mrshlaf/smart-plant-system/presentation/SmartPlantSystem_Presentation.pptx

GROUP 21

SMART PLANT
SYSTEM

Sistem Penyiram Tanaman Otomatis Berbasis Arduino

1. Marshal Aufa Diliyana(2406346913)

2. Syifa Naila Maulidya(2406436940)

3. Zahir(2406487084)

4. Muhamad Rifqi Fadil Itsnain (2406355306)

5. Arya Wibawa Atmanegara (2406420431)

## Slide 2

PENDAHULUAN

Merawat tanaman bukan hal yang mudah, terutama bagi kamu yang sibuk atau sering lupa menyiram. Terlalu sedikit air membuat tanaman layu, tapi terlalu banyak justru merusaknya.
Smart Plant Guardian hadir sebagai Solusi, sistem pintar yang secara otomatis memantau kelembapan tanah dan menyiram tanaman tepat saat dibutuhkan. Dilengkapi sensor suhu dan kelembapan udara, sistem ini menyesuaikan jumlah air dengan kondisi lingkungan secara real-time.

Masalah Utama

• Lupa menyiram tanaman

• Takaran air tidak tepat

• Tidak tahu kondisi tanah

• Tidak ada sistem otomatis

Dengan Smart Plant Guardian, tanaman akan selalu terhidrasi dengan takaran yang tepat dan otomatis tanpa perlu diingat.

## Slide 3

PROJECT DESCRIPTION

Apa yang dilakukan sistem ini?

Siram Otomatis

Sensor tanah mendeteksi apakah tanah kering. Kalau kering, pompa langsung nyala secara otomatis.

Pantau Lingkungan

Sensor suhu dan kelembapan udara memastikan jumlah air yang diberikan sesuai cuaca hari itu.

Tampil di Layar

LCD menampilkan status kelembapan tanah, suhu, dan kondisi pompa secara real-time.

Fitur Utama:

Deteksi Kelembapan

Mode Manual

Alert Bunyi

Deteksi Suhu

Pantau Suhu

Siram Otomatis

## Slide 4

OBJECTIVES

Tujuan dari proyek ini adalah sebagai berikut:

Menyiram tanaman secara otomatis saat tanah mulai kering, tanpa perlu campur tangan manusia.

01

Menyesuaikan jumlah air yang diberikan berdasarkan suhu udara dan kelembapan sekitar.

02

Memberikan peringatan berupa bunyi (buzzer) ketika kelembapan tanah sangat rendah / kritis.

Menampilkan informasi kondisi tanaman secara langsung di layar LCD.

03

04

Memungkinkan pemilik menyiram secara manual kapan saja dengan menekan tombol.

05

Menyimpan pengaturan batas kelembapan agar tidak hilang saat alat dimatikan.

06

## Slide 5

EQUIPMENT

Tools & komponen yang digunakan:

1. Arduino Uno

Otak utama sistem

2. Sensor Tanah

Cek basah/kering tanah

3. Sensor BME280

Ukur suhu & kelembapan udara

4. Pompa Air Mini

Menyiram secara otomatis

5. LCD 16x2

Tampilkan status sistem

6. Buzzer

Bunyi saat kondisi kritis

7. 2x Tombol

Kontrol manual & atur batas

8. MOSFET + Dioda

Pengaman & kontrol pompa

9. Proteus / Arduino IDE

Simulasi & upload program

## Slide 6

IMPLEMENTATION

Cara kerja sistem secara sederhana:

Baca Sensor

Setiap 1 detik, Arduino membaca kadar air di tanah dan suhu udara sekitar.

Tampilkan Info

LCD langsung menampilkan kelembapan, suhu, dan status pompa supaya pemilik bisa memantau.

Ambil Keputusan

Sistem memutuskan apakah tanah perlu disiram atau tidak berdasarkan batas yang sudah diatur.

Beri Peringatan

Kalau tanah sangat kering (kondisi kritis), buzzer berbunyi sebagai alarm tanda bahaya.

Nyalakan Pompa

Kalau tanah kering, pompa air otomatis menyala. Makin kering tanahnya, makin kencang pompanya.

Kontrol Manual

Tombol manual memungkinkan pemilik menyiram kapan saja, dan tombol kedua untuk atur batas kelembapan.

## Slide 7

TESTING

Pompa menyala otomatis tepat waktu sesuai interval yang diatur. LCD dan buzzer aktif bersamaan.

Uji Timer

Berhasil

Saat tombol ditekan, pompa langsung menyala tanpa menunggu sensor. Respon instan.

Uji Tombol Manual

Berhasil

Sensor berhasil membedakan kondisi tanah basah dan kering. Pompa menyala hanya saat tanah kering.

Uji Sensor Tanah

Berhasil

Buzzer berbunyi dan LCD menampilkan pesan sesuai kondisi dan semuanya berjalan normal.

Uji Buzzer & LCD

Berhasil

Semua pengujian berhasil dan sistem berjalan sesuai harapan tanpa error yang berarti.

## Slide 8

ANALYSIS

Smart Plant Guardian telah berjalan sesuai tujuan.

Yang Berjalan Baik

▸ Pompa menyiram otomatis dan berhenti sendiri saat tanah cukup basah

▸ Tombol manual berfungsi sempurna dan bisa menyiram kapan saja

▸ Sensor berhasil membedakan kondisi kering dan basah dengan akurat

▸ LCD menampilkan informasi yang mudah dibaca

▸ Pengaturan batas kelembapan tersimpan meski alat dimatikan

Bisa Dikembangkan

▸ Tambah notifikasi ke smartphone

▸ Riwayat data penyiraman

▸ Kontrol jarak jauh via WiFi

▸ Deteksi jenis tanaman berbeda

Sistem ini efektif dan efisien untuk menjaga tanaman tetap sehat. Cocok untuk rumahan maupun skala kecil. Pengembangan ke depan bisa difokuskan pada konektivitas jarak jauh.

## Slide 9

CONCLUSION

Smart Plant Guardian berhasil menjadi solusi nyata untuk masalah lupa menyiram tanaman. Dengan menggabungkan sensor, pompa, dan tampilan LCD dalam satu sistem otomatis yang mudah digunakan, proyek ini membuktikan bahwa teknologi sederhana bisa memberi dampak nyata dalam kehidupan sehari-hari.

Otomatis Penuh

Menyiram sendiri tanpa harus diingat atau diawasi terus-menerus.

Mudah Dipakai

Tombol manual dan layar LCD membuatnya ramah pengguna dari semua kalangan.

Bisa Berkembang

Sistem ini bisa dikembangkan lebih lanjut, misalnya ditambah notifikasi HP.

01

02

03

Smart Plant System • Final Project • Arduino Uno

## Slide 10

Result

Rangkaian Proteus

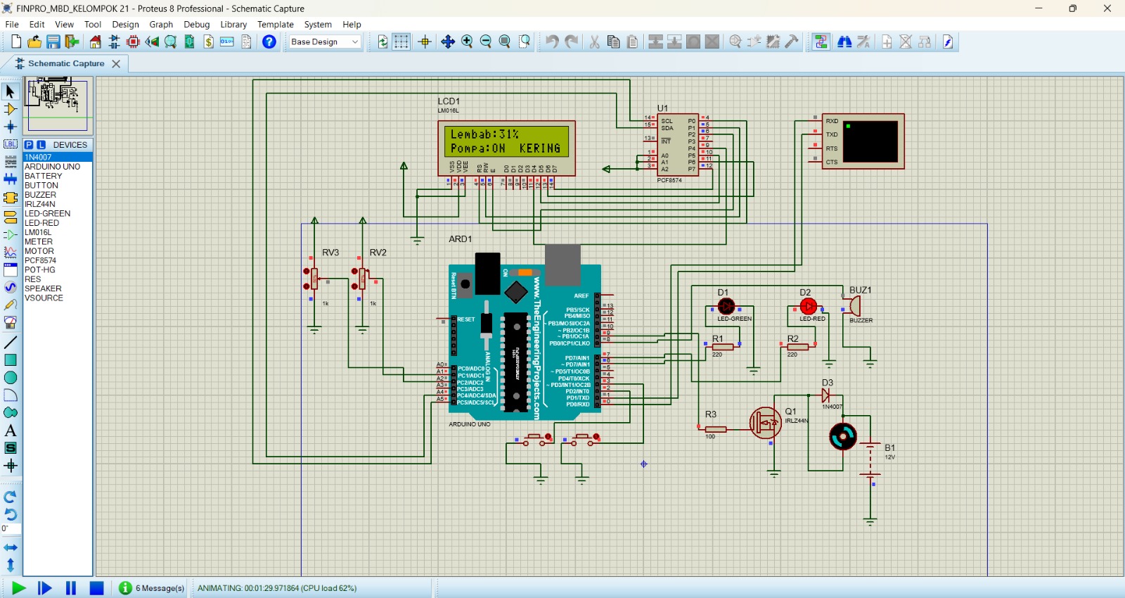
[picture p3: figure]
Kering
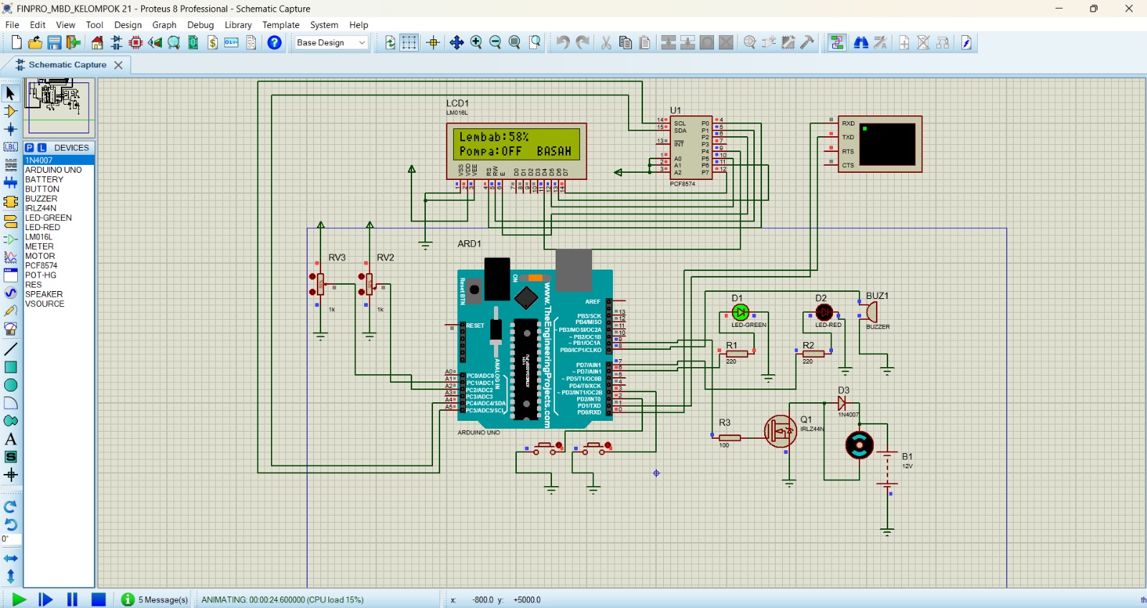
[picture p4: figure]
Basah

PRAKTIKUM SISTEM EMBEDDED FTUI 2026

## Slide 11

Result

Rangkaian Asli


PRAKTIKUM SISTEM EMBEDDED FTUI 2026

## Slide 12

TERIMA KASIH

PRAKTIKUM SISTEM EMBEDDED FTUI 2026 - KELOMPOK 21
