mrshlaf/smart-plant-system/documentation/serial-monitor-output.png

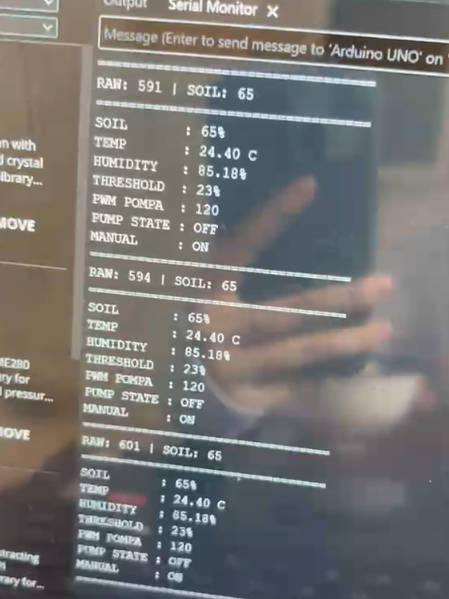
documentation/serial-monitor-output.png
