mrshlaf/smart-plant-system/(list of files, drawings)

Other design files:
simulation/SmartPlantSystem.pdsprj
