mrshlaf/smart-plant-system/(commit log)

2026-05-17 initialize repository with AVR assembly firmware, hardware documentation, and comprehensive project report
2026-05-17 implement Smart Plant System firmware and add project documentation and simulation files
    [SmartPlantSystem.pdsprj]
