mrshlaf/smart-plant-system/(notices)

Notices in the files:
README.md:
License: MIT
